keatinge/cnc-pen-plotter/images/driver_top.jpg

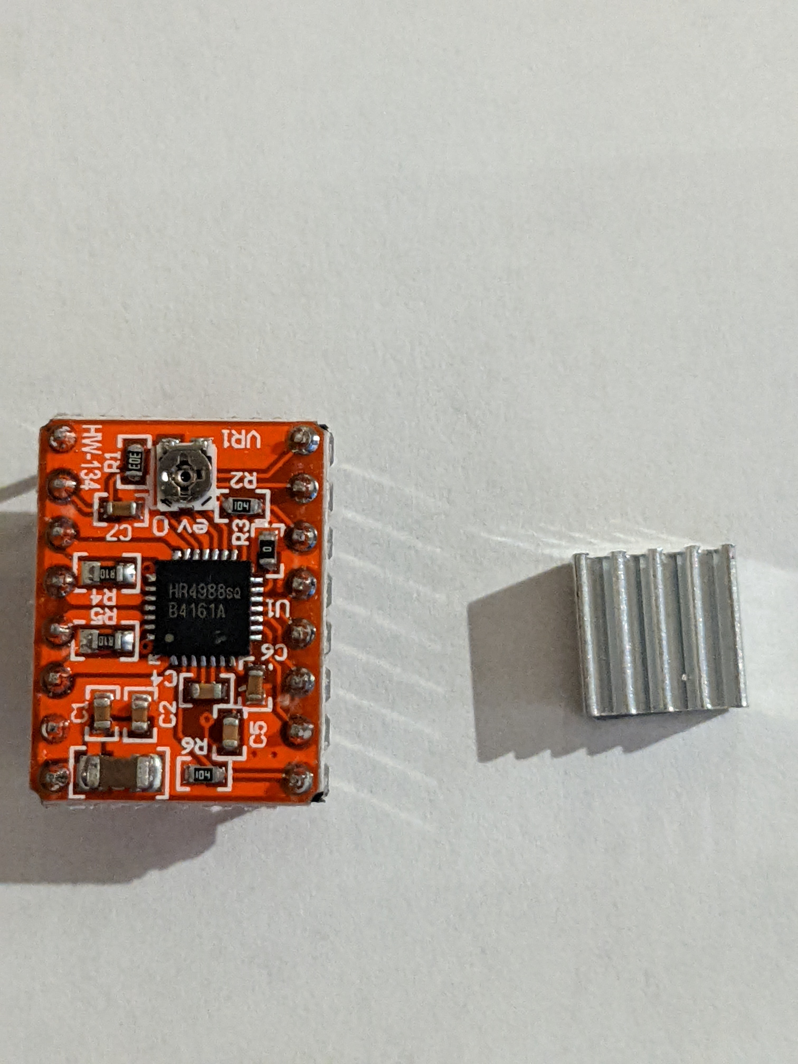
images/driver_top.jpg
