keatinge/cnc-pen-plotter/images/component_cam.png

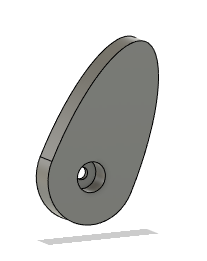
images/component_cam.png
