keatinge/cnc-pen-plotter/images/component_cam_higher_belt_holder.png

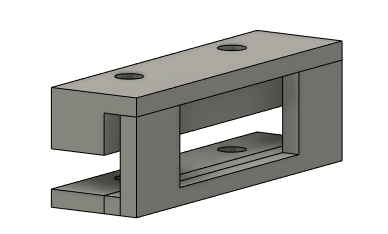
images/component_cam_higher_belt_holder.png
