keatinge/cnc-pen-plotter/images/component_frame_pulley.png

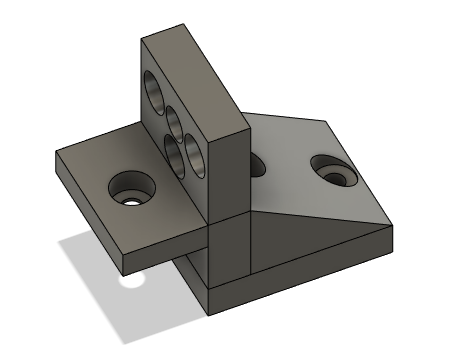
images/component_frame_pulley.png
