keatinge/cnc-pen-plotter/images/component_frame_stepper_mount.png

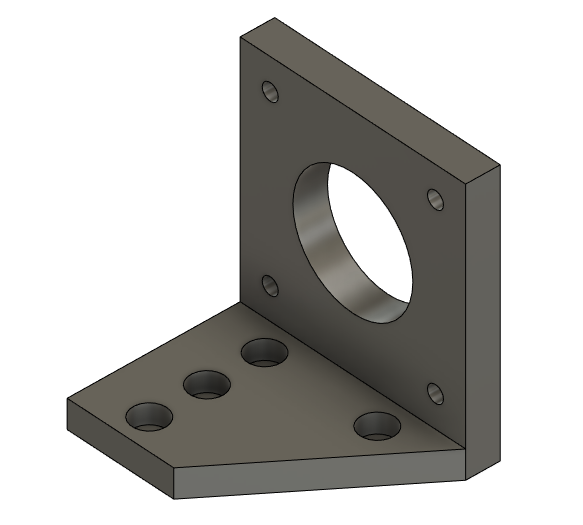
images/component_frame_stepper_mount.png
