keatinge/cnc-pen-plotter/images/component_x_lim_switch_holder.png

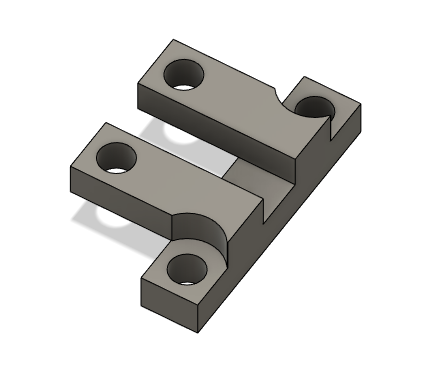
images/component_x_lim_switch_holder.png
