keatinge/cnc-pen-plotter/images/component_y_stepper_mount.png

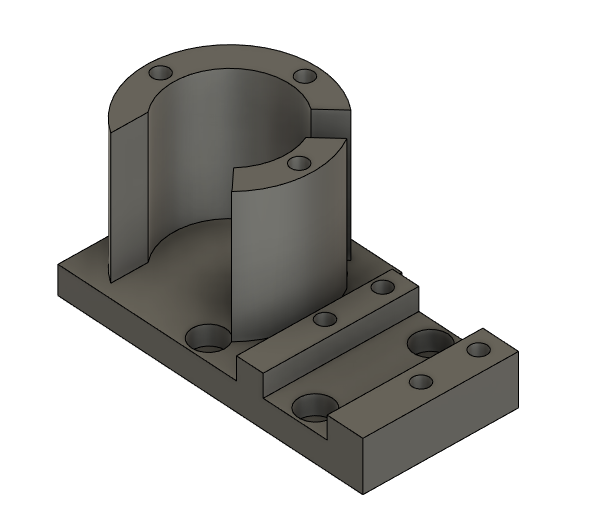
images/component_y_stepper_mount.png
