keatinge/cnc-pen-plotter/tiger_gcode.h

#include "plotter.h"
const float tiger_gcode[] PROGMEM = {
PEN_UP,
PEN_UP,
31.8900,
0.0900,
PEN_DOWN,
PEN_DOWN,
31.4600,
0.2100,
30.0600,
0.6000,
29.9200,
0.6500,
28.0400,
1.3200,
26.9700,
1.7100,
26.8400,
1.7500,
25.9100,
2.1000,
24.8500,
2.5000,
24.5400,
2.6900,
24.2500,
3.1400,
24.1300,
3.3600,
24.1200,
3.0700,
24.0600,
2.7700,
23.5200,
2.9300,
23.0300,
3.0900,
22.9500,
3.4200,
22.8100,
4.0500,
22.7500,
4.3700,
22.4800,
3.4800,
22.4200,
3.2900,
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
PEN_UP,
PEN_UP,
33.7200,
1.7800,
PEN_DOWN,
PEN_DOWN,
34.1700,
1.9200,
35.5800,
2.3700,
35.8300,
2.4700,
36.7600,
2.8400,
37.9300,
3.3200,
38.5700,
3.6000,
38.5700,
3.8100,
38.5000,
4.1100,
38.1600,
4.3000,
37.2000,
4.3800,
37.1800,
4.3800,
36.1800,
4.4900,
35.1600,
4.6100,
34.3500,
4.5800,
33.9900,
4.5600,
32.6300,
4.4800,
32.3100,
4.5000,
30.9900,
4.5800,
30.4500,
4.6700,
30.1200,
4.5900,
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
PEN_UP,
PEN_UP,
28.6800,
5.6700,
PEN_DOWN,
PEN_DOWN,
29.1100,
5.7300,
30.5400,
5.9500,
30.7700,
6.0300,
31.9600,
6.4200,
32.2200,
6.5500,
32.2200,
6.6300,
32.1900,
7.7200,
32.1800,
7.9100,
32.1200,
9.0900,
32.0300,
9.2800,
31.8400,
9.3900,
31.2700,
9.7500,
30.6900,
10.1200,
29.9500,
10.3400,
29.6200,
10.4600,
28.3500,
10.9100,
28.2400,
11.0000,
27.3200,
11.6800,
26.8400,
12.1400,
26.7700,
12.2100,
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
PEN_UP,
PEN_UP,
22.5900,
20.4100,
PEN_DOWN,
PEN_DOWN,
22.4100,
21.2500,
22.4000,
21.3300,
22.3600,
22.4200,
22.3700,
22.5200,
22.4600,
23.5100,
22.5600,
24.6100,
22.6700,
24.9900,
23.0900,
26.3200,
23.5600,
27.0900,
23.5700,
27.0900,
24.0200,
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
59.7600,
50.4300,
59.6000,
50.0700,
59.4800,
50.1500,
59.6000,
50.3200,
59.8100,
50.9600,
60.5800,
51.7700,
61.5700,
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
PEN_UP,
PEN_UP,
50.4300,
35.0400,
PEN_DOWN,
PEN_DOWN,
50.4200,
35.1000,
50.3100,
36.0900,
50.1900,
37.1400,
50.1800,
37.2300,
50.0400,
38.2200,
49.8900,
39.3000,
49.5600,
40.1500,
49.5200,
40.2000,
48.8800,
41.0400,
48.7000,
41.2000,
47.7700,
42.0200,
47.7200,
42.0700,
46.9500,
42.8200,
46.7500,
43.1800,
46.0400,
44.4100,
45.9900,
44.5100,
45.5000,
45.3800,
44.9600,
46.3500,
44.8600,
46.5700,
45.7300,
46.3500,
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
PEN_UP,
PEN_UP,
42.3600,
20.6800,
PEN_DOWN,
PEN_DOWN,
42.2400,
21.1100,
41.9700,
22.0700,
41.5800,
23.4600,
41.5500,
23.5100,
41.1000,
24.4000,
40.6300,
25.3500,
40.6300,
25.3600,
40.1100,
26.2200,
39.9900,
26.5400,
39.5000,
27.7900,
39.3200,
28.1700,
38.7200,
29.4500,
38.1600,
29.8600,
37.4400,
30.4200,
37.0000,
30.9900,
36.8000,
31.6300,
36.7900,
32.4400,
36.8000,
32.5100,
36.9800,
33.5600,
37.3200,
34.3500,
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
PEN_UP,
PEN_UP,
0.0000,
0.0000,
};
