keatinge/cnc-pen-plotter/cat_gcode.h

#include "plotter.h"
const float cat_gcode[] PROGMEM = {
PEN_UP,
PEN_UP,
19.5800,
0.0400,
PEN_DOWN,
PEN_DOWN,
19.0400,
0.1500,
18.9800,
0.1600,
17.9400,
0.3800,
17.3200,
0.8100,
17.0500,
1.3300,
16.9700,
2.1800,
16.8800,
2.9500,
16.6000,
2.5600,
16.4200,
2.2900,
15.6900,
1.2000,
15.5800,
1.0900,
14.7600,
0.2700,
14.2000,
0.1900,
14.1000,
0.2000,
13.0100,
0.2800,
12.9600,
0.2900,
11.9300,
0.4600,
11.4200,
0.7500,
11.1800,
1.1800,
11.2800,
1.6700,
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
PEN_UP,
PEN_UP,
0.0000,
0.0000,
};
